Bihyungbetter/Mechanical-Keyboard/cad/Part Studio 1 - Part 1.step

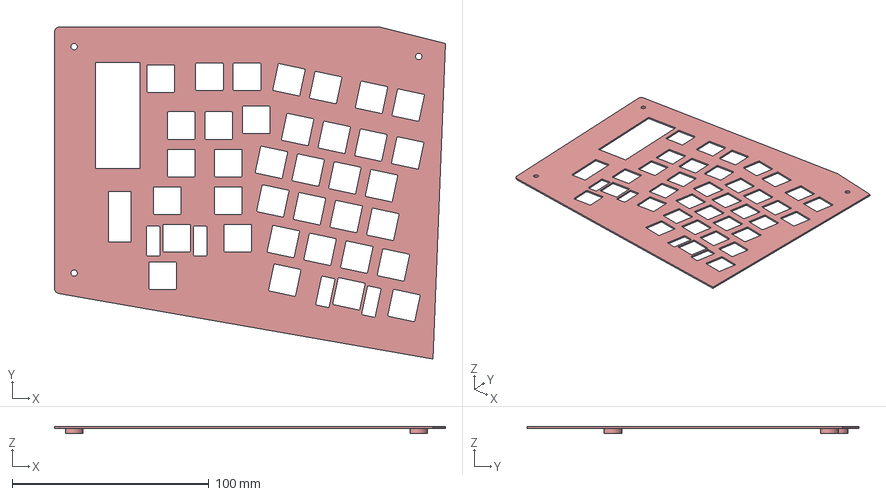
[picture p1: CAD file, 2026-08-08]
cad/Part Studio 1 - Part 1.step
198.6 x 168.6 x 3.58 mm
