Bihyungbetter/Mechanical-Keyboard/cad/Part Studio 1 - Part 2.step

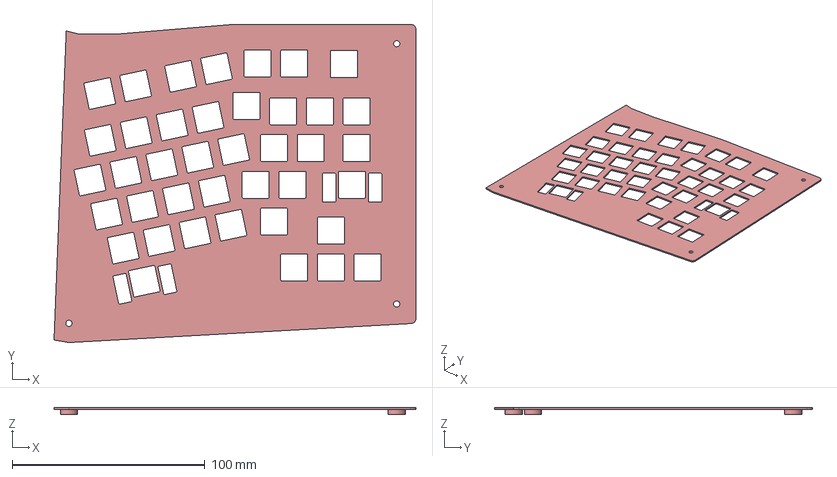
[picture p2: CAD file, 2026-08-08]
cad/Part Studio 1 - Part 2.step
187.7 x 165.0 x 3.58 mm
