Bihyungbetter/Mechanical-Keyboard/cad/Part Studio 1 - Part 5.step

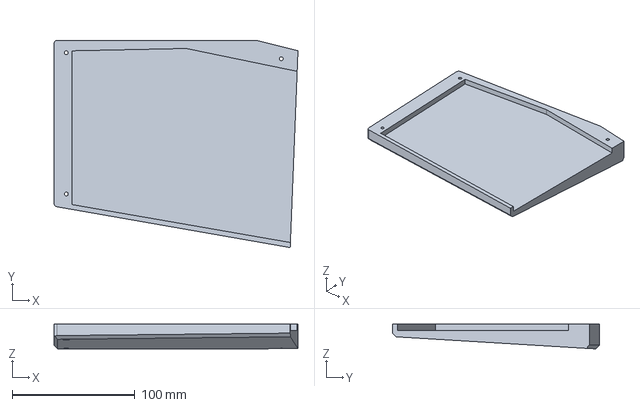
[picture p3: CAD file, 2026-08-08]
cad/Part Studio 1 - Part 5.step
198.6 x 168.6 x 20.0 mm
