Bihyungbetter/Mechanical-Keyboard/cad/Part Studio 1 - Part 4.step

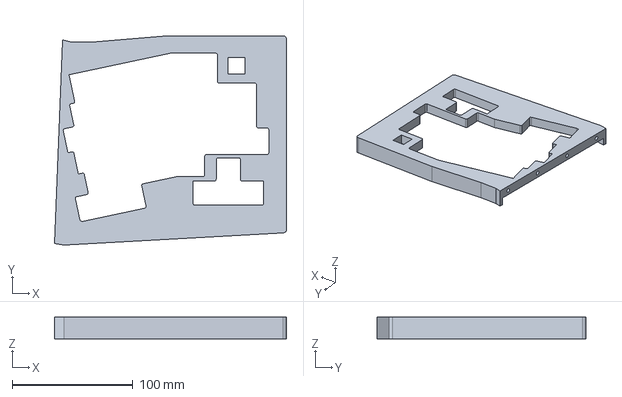
[picture p4: CAD file, 2026-08-08]
cad/Part Studio 1 - Part 4.step
191.9 x 173.0 x 18.0 mm
