Bihyungbetter/Mechanical-Keyboard/cad/Part Studio 1 - Part 3.step

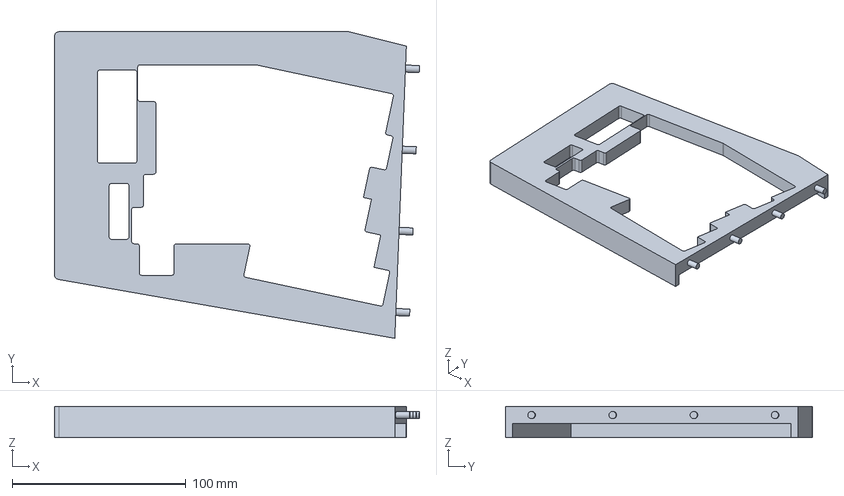
[picture p5: CAD file, 2026-08-08]
cad/Part Studio 1 - Part 3.step
210.3 x 176.7 x 18.0 mm
