Bihyungbetter/Mechanical-Keyboard/cad/Part Studio 1 - Part 6.step

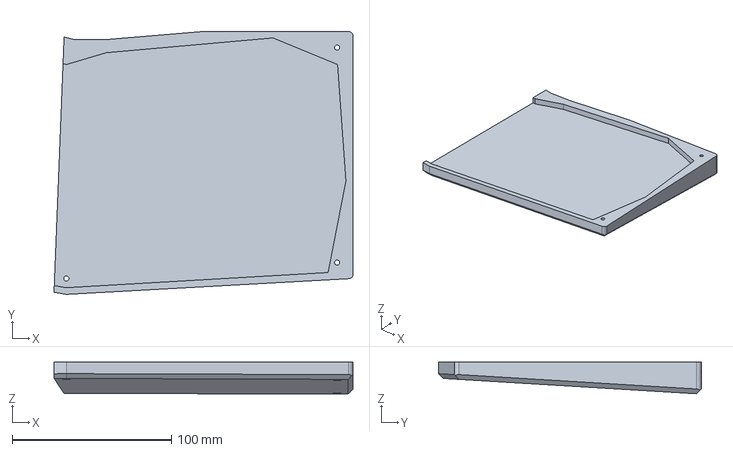
[picture p6: CAD file, 2026-08-08]
cad/Part Studio 1 - Part 6.step
187.7 x 165.0 x 19.8 mm
