Bihyungbetter/Mechanical-Keyboard/(list of files, cad)

Other CAD files:
cad/Master Assembly Keyboard.step
