Bihyungbetter/Mechanical-Keyboard/pcb/Eastern Style Keyboard.kicad_pcb

## KiCad design pcb/Eastern Style Keyboard.kicad_pcb (2026-08-08)

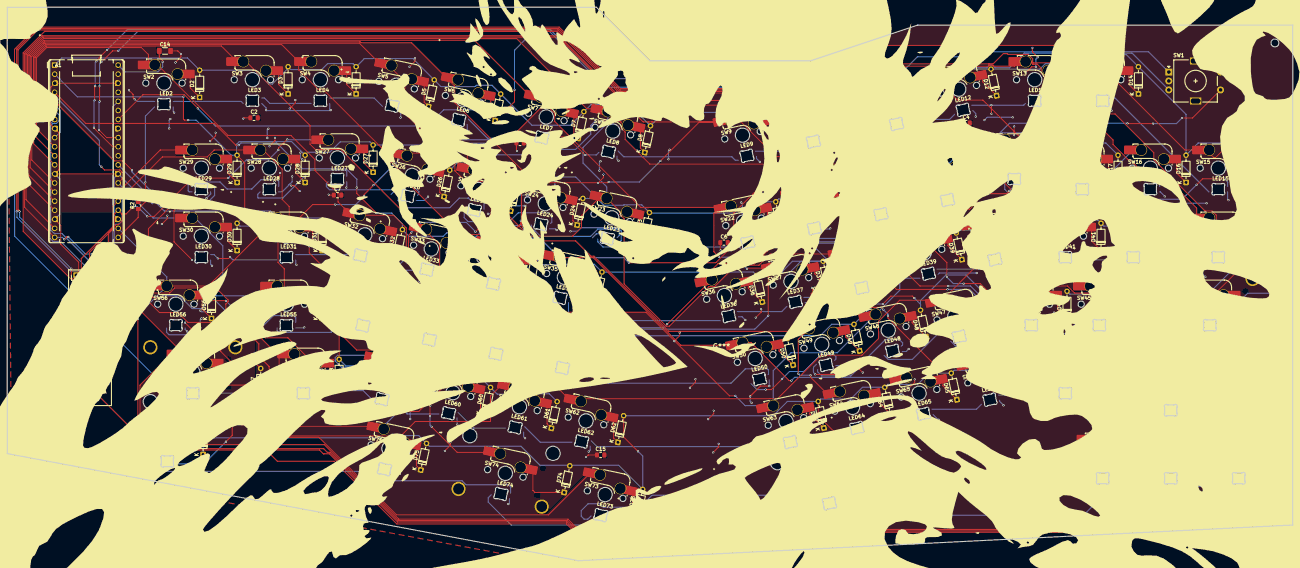
[picture p7: board Eastern Style Keyboard.kicad_pcb from above]

Board: 2 copper layers, 360.0 x 155.0 mm, 255 parts (0 on the bottom side), 178 nets.

Parts:
A1: RaspberryPi_Pico; RaspberryPi_Pico_Common_THT
C2, C3, C4, C5, C6, C7, C8, C9, C10, C11, C12, C13, C15, C16, C17: 100nF; C_0805_2012Metric_Pad1.18x1.45mm_HandSolder
C14: 100µF 10V; C_1206_3216Metric_Pad1.33x1.80mm_HandSolder
D2, D3, D4, D5, D6, D7, D8, D9, D10, D11, D12, D13, D14, D15, D16, D17, D18, D19, D20, D21, D22, D23, D24, D25, D26, D27, D28, D29, D30, D31, D32, D33, D34, D35, D36, D37, D38, D39, D40, D41, D42, D43, D44, D45, D46, D47, D48, D49, D50, D51, D52, D53, D54, D55, D56, D57, D58, D59, D60, D61, D62, D63, D64, D65, D66, D67, D68, D69, D70, D71, D72, D73, D74, D75, D76: 1N4148; D_DO-35_SOD27_P7.62mm_Horizontal
H1, H2, H3, H4, H5, H6: MountingHole; MountingHole_2.2mm_M2
LED2, LED3, LED4, LED5, LED6, LED7, LED8, LED9, LED10, LED11, LED12, LED13, LED14, LED15, LED16, LED17, LED18, LED19, LED20, LED21, LED22, LED23, LED24, LED25, LED26, LED27, LED28, LED29, LED30, LED31, LED32, LED33, LED34, LED35, LED36, LED37, LED38, LED39, LED40, LED41, LED42, LED43, LED44, LED45, LED46, LED47, LED48, LED49, LED50, LED51, LED52, LED53, LED54, LED55, LED56, LED57, LED58, LED59, LED60, LED61, LED62, LED63, LED64, LED65, LED66, LED67, LED68, LED69, LED70, LED71, LED72, LED73, LED74, LED75, LED76: SK6812MINI-E; SK6812MINI-E_fixed
R2: 330 Ω; R_0805_2012Metric_Pad1.20x1.40mm_HandSolder
S1: MX_stab; STAB_MX_P_2u
S2: MX_stab; STAB_MX_P_2.75u
S3, S4: MX_stab; STAB_MX_P_2.25u
SW1: RotaryEncoder_Switch; RotaryEncoder_Alps_EC11E-Switch_Vertical_H20mm
SW2, SW3, SW4, SW5, SW6, SW7, SW8, SW9, SW10, SW11, SW12, SW13, SW14, SW15, SW16, SW17, SW18, SW19, SW20, SW21, SW22, SW23, SW24, SW25, SW26, SW27, SW28, SW29, SW30, SW31, SW32, SW33, SW34, SW35, SW36, SW37, SW38, SW39, SW40, SW41, SW42, SW43, SW44, SW45, SW46, SW47, SW48, SW49, SW50, SW51, SW52, SW53, SW54, SW55, SW56, SW57, SW58, SW59, SW60, SW61, SW62, SW63, SW64, SW65, SW66, SW67, SW68, SW69, SW70, SW71, SW72, SW73, SW74, SW75, SW76: SW_Push; SW_MX_HS_CPG151101S11_1u
U1: ER_OLEDM0.91_1x-I2C

Connections:
+3.3V: A1.36 (3V3), U1.2 (VCC)
Column 0: A1.10 (GPIO7), SW2.2, SW17.2, SW32.2, SW47.2, SW62.2
Column 1: A1.11 (GPIO8), SW3.2, SW18.2, SW33.2, SW48.2, SW63.2
Column 2: A1.12 (GPIO9), SW4.2, SW19.2, SW34.2, SW49.2, SW64.2
Column 3: A1.14 (GPIO10), SW5.2, SW20.2, SW35.2, SW50.2, SW65.2
Column 4: A1.15 (GPIO11), SW6.2, SW21.2, SW36.2, SW51.2, SW66.2
Column 5: A1.16 (GPIO12), SW7.2, SW22.2, SW37.2, SW52.2, SW67.2
Column 6: A1.17 (GPIO13), SW8.2, SW23.2, SW38.2, SW53.2, SW68.2
Column 7: A1.19 (GPIO14), SW9.2, SW24.2, SW39.2, SW54.2, SW69.2
Column 8: A1.20 (GPIO15), SW10.2, SW25.2, SW40.2, SW55.2, SW70.2
Column 9: A1.22 (GPIO17), SW11.2, SW26.2, SW41.2, SW56.2, SW71.2
Column 10: A1.24 (GPIO18), SW12.2, SW27.2, SW42.2, SW57.2, SW72.2
Column 11: A1.25 (GPIO19), SW13.2, SW28.2, SW43.2, SW58.2, SW73.2
Column 12: A1.26 (GPIO20), SW14.2, SW29.2, SW44.2, SW59.2, SW74.2
Column 13: A1.27 (GPIO21), SW15.2, SW30.2, SW45.2, SW60.2, SW75.2
Column 14: A1.29 (GPIO22), SW16.2, SW31.2, SW46.2, SW61.2, SW76.2
GND: A1.3 (GND), A1.8 (GND), A1.13 (GND), A1.18 (GND), A1.23 (GND), A1.28 (GND), A1.38 (GND), C2.1, C3.1, C4.1, C5.1, C6.1, C7.1, C8.1, C9.1, C10.1, C11.1, C12.1, C13.1, C14.2, C15.1, C16.1, C17.1, LED2.1 (VSS), LED3.1 (VSS), LED4.1 (VSS), LED5.1 (VSS), LED6.1 (VSS), LED7.1 (VSS), LED8.1 (VSS), LED9.1 (VSS), LED10.1 (VSS), LED11.1 (VSS), LED12.1 (VSS), LED13.1 (VSS), LED14.1 (VSS), LED15.1 (VSS), LED16.1 (VSS), LED17.1 (VSS), LED18.1 (VSS), LED19.1 (VSS), LED20.1 (VSS), LED21.1 (VSS), LED22.1 (VSS), LED23.1 (VSS), LED24.1 (VSS), LED25.1 (VSS), LED26.1 (VSS), LED27.1 (VSS), LED28.1 (VSS), LED29.1 (VSS), LED30.1 (VSS), LED31.1 (VSS), LED32.1 (VSS), LED33.1 (VSS), LED34.1 (VSS), LED35.1 (VSS), LED36.1 (VSS), LED37.1 (VSS), LED38.1 (VSS), LED39.1 (VSS), LED40.1 (VSS), LED41.1 (VSS), LED42.1 (VSS), LED43.1 (VSS), LED44.1 (VSS), LED45.1 (VSS), LED46.1 (VSS), LED47.1 (VSS), LED48.1 (VSS), LED49.1 (VSS), LED50.1 (VSS), LED51.1 (VSS), LED52.1 (VSS), LED53.1 (VSS), LED54.1 (VSS), LED55.1 (VSS), LED56.1 (VSS), LED57.1 (VSS), LED58.1 (VSS), LED59.1 (VSS), LED60.1 (VSS), LED61.1 (VSS), LED62.1 (VSS), LED63.1 (VSS), LED64.1 (VSS), LED65.1 (VSS), LED66.1 (VSS), LED67.1 (VSS), LED68.1 (VSS), LED69.1 (VSS), LED70.1 (VSS), LED71.1 (VSS), LED72.1 (VSS), LED73.1 (VSS), LED74.1 (VSS), LED75.1 (VSS), LED76.1 (VSS), R2.2, SW1.C, SW1.S2, U1.1 (GND)
KnobA: A1.31 (GPIO26_ADC0), SW1.A
KnobB: A1.32 (GPIO27_ADC1), SW1.B
LED Power: A1.40 (VBUS), C2.2, C3.2, C4.2, C5.2, C6.2, C7.2, C8.2, C9.2, C10.2, C11.2, C12.2, C13.2, C14.1, C15.2, C16.2, C17.2, LED2.3 (VDD), LED3.3 (VDD), LED4.3 (VDD), LED5.3 (VDD), LED6.3 (VDD), LED7.3 (VDD), LED8.3 (VDD), LED9.3 (VDD), LED10.3 (VDD), LED11.3 (VDD), LED12.3 (VDD), LED13.3 (VDD), LED14.3 (VDD), LED15.3 (VDD), LED16.3 (VDD), LED17.3 (VDD), LED18.3 (VDD), LED19.3 (VDD), LED20.3 (VDD), LED21.3 (VDD), LED22.3 (VDD), LED23.3 (VDD), LED24.3 (VDD), LED25.3 (VDD), LED26.3 (VDD), LED27.3 (VDD), LED28.3 (VDD), LED29.3 (VDD), LED30.3 (VDD), LED31.3 (VDD), LED32.3 (VDD), LED33.3 (VDD), LED34.3 (VDD), LED35.3 (VDD), LED36.3 (VDD), LED37.3 (VDD), LED38.3 (VDD), LED39.3 (VDD), LED40.3 (VDD), LED41.3 (VDD), LED42.3 (VDD), LED43.3 (VDD), LED44.3 (VDD), LED45.3 (VDD), LED46.3 (VDD), LED47.3 (VDD), LED48.3 (VDD), LED49.3 (VDD), LED50.3 (VDD), LED51.3 (VDD), LED52.3 (VDD), LED53.3 (VDD), LED54.3 (VDD), LED55.3 (VDD), LED56.3 (VDD), LED57.3 (VDD), LED58.3 (VDD), LED59.3 (VDD), LED60.3 (VDD), LED61.3 (VDD), LED62.3 (VDD), LED63.3 (VDD), LED64.3 (VDD), LED65.3 (VDD), LED66.3 (VDD), LED67.3 (VDD), LED68.3 (VDD), LED69.3 (VDD), LED70.3 (VDD), LED71.3 (VDD), LED72.3 (VDD), LED73.3 (VDD), LED74.3 (VDD), LED75.3 (VDD), LED76.3 (VDD)
Led S: A1.21 (GPIO16), LED2.2 (DIN), R2.1
unnamed: A1.6 (GPIO4), U1.4 (SDA)
unnamed: A1.7 (GPIO5), U1.3 (SCL)
unnamed: D2.1 (K), SW2.1
unnamed: D3.1 (K), SW3.1
unnamed: D4.1 (K), SW4.1
unnamed: D5.1 (K), SW5.1
unnamed: D6.1 (K), SW6.1
unnamed: D7.1 (K), SW7.1
unnamed: D8.1 (K), SW8.1
unnamed: D9.1 (K), SW9.1
unnamed: D10.1 (K), SW10.1
unnamed: D11.1 (K), SW11.1
unnamed: D12.1 (K), SW12.1
unnamed: D13.1 (K), SW13.1
unnamed: D14.1 (K), SW14.1
unnamed: D15.1 (K), SW15.1
unnamed: D16.1 (K), SW16.1
unnamed: D17.1 (K), SW17.1
unnamed: D18.1 (K), SW18.1
unnamed: D19.1 (K), SW19.1
unnamed: D20.1 (K), SW20.1
unnamed: D21.1 (K), SW21.1
unnamed: D22.1 (K), SW22.1
unnamed: D23.1 (K), SW23.1
unnamed: D24.1 (K), SW24.1
unnamed: D25.1 (K), SW25.1
unnamed: D26.1 (K), SW26.1
unnamed: D27.1 (K), SW27.1
unnamed: D28.1 (K), SW28.1
unnamed: D29.1 (K), SW29.1
unnamed: D30.1 (K), SW30.1
unnamed: D31.1 (K), SW31.1
unnamed: D32.1 (K), SW32.1
unnamed: D33.1 (K), SW33.1
unnamed: D34.1 (K), SW34.1
unnamed: D35.1 (K), SW35.1
unnamed: D36.1 (K), SW36.1
unnamed: D37.1 (K), SW37.1
unnamed: D38.1 (K), SW38.1
unnamed: D39.1 (K), SW39.1
unnamed: D40.1 (K), SW40.1
unnamed: D41.1 (K), SW41.1
unnamed: D42.1 (K), SW42.1
unnamed: D43.1 (K), SW43.1
unnamed: D44.1 (K), SW44.1
unnamed: D45.1 (K), SW45.1
unnamed: D46.1 (K), SW46.1
unnamed: D47.1 (K), SW47.1
unnamed: D48.1 (K), SW48.1
unnamed: D49.1 (K), SW49.1
unnamed: D50.1 (K), SW50.1
unnamed: D51.1 (K), SW51.1
unnamed: D52.1 (K), SW52.1
unnamed: D53.1 (K), SW53.1
unnamed: D54.1 (K), SW54.1
unnamed: D55.1 (K), SW55.1
unnamed: D56.1 (K), SW56.1
unnamed: D57.1 (K), SW57.1
unnamed: D58.1 (K), SW58.1
unnamed: D59.1 (K), SW59.1
unnamed: D60.1 (K), SW60.1
unnamed: D61.1 (K), SW61.1
unnamed: D62.1 (K), SW62.1
unnamed: D63.1 (K), SW63.1
unnamed: D64.1 (K), SW64.1
unnamed: D65.1 (K), SW65.1
unnamed: D66.1 (K), SW66.1
unnamed: D67.1 (K), SW67.1
unnamed: D68.1 (K), SW68.1
unnamed: D69.1 (K), SW69.1
unnamed: D70.1 (K), SW70.1
unnamed: D71.1 (K), SW71.1
unnamed: D72.1 (K), SW72.1
unnamed: D73.1 (K), SW73.1
unnamed: D74.1 (K), SW74.1
unnamed: D75.1 (K), SW75.1
unnamed: D76.1 (K), SW76.1
unnamed: LED2.4 (DOUT), LED3.2 (DIN)
unnamed: LED3.4 (DOUT), LED4.2 (DIN)
unnamed: LED4.4 (DOUT), LED5.2 (DIN)
unnamed: LED5.4 (DOUT), LED6.2 (DIN)
unnamed: LED6.4 (DOUT), LED7.2 (DIN)
unnamed: LED7.4 (DOUT), LED8.2 (DIN)
unnamed: LED8.4 (DOUT), LED9.2 (DIN)
unnamed: LED9.4 (DOUT), LED10.2 (DIN)
unnamed: LED10.4 (DOUT), LED11.2 (DIN)
unnamed: LED11.4 (DOUT), LED12.2 (DIN)
unnamed: LED12.4 (DOUT), LED13.2 (DIN)
unnamed: LED13.4 (DOUT), LED14.2 (DIN)
unnamed: LED14.4 (DOUT), LED15.2 (DIN)
unnamed: LED15.4 (DOUT), LED16.2 (DIN)
unnamed: LED16.4 (DOUT), LED17.2 (DIN)
unnamed: LED17.4 (DOUT), LED18.2 (DIN)
unnamed: LED18.4 (DOUT), LED19.2 (DIN)
unnamed: LED19.4 (DOUT), LED20.2 (DIN)
unnamed: LED20.4 (DOUT), LED21.2 (DIN)
unnamed: LED21.4 (DOUT), LED22.2 (DIN)
unnamed: LED22.4 (DOUT), LED23.2 (DIN)
unnamed: LED23.4 (DOUT), LED24.2 (DIN)
unnamed: LED24.4 (DOUT), LED25.2 (DIN)
unnamed: LED25.4 (DOUT), LED26.2 (DIN)
unnamed: LED26.4 (DOUT), LED27.2 (DIN)
unnamed: LED27.4 (DOUT), LED28.2 (DIN)
unnamed: LED28.4 (DOUT), LED29.2 (DIN)
unnamed: LED29.4 (DOUT), LED30.2 (DIN)
unnamed: LED30.4 (DOUT), LED31.2 (DIN)
unnamed: LED31.4 (DOUT), LED32.2 (DIN)
unnamed: LED32.4 (DOUT), LED33.2 (DIN)
unnamed: LED33.4 (DOUT), LED34.2 (DIN)
unnamed: LED34.4 (DOUT), LED35.2 (DIN)
unnamed: LED35.4 (DOUT), LED36.2 (DIN)
unnamed: LED36.4 (DOUT), LED37.2 (DIN)
unnamed: LED37.4 (DOUT), LED38.2 (DIN)
unnamed: LED38.4 (DOUT), LED39.2 (DIN)
unnamed: LED39.4 (DOUT), LED40.2 (DIN)
unnamed: LED40.4 (DOUT), LED41.2 (DIN)
unnamed: LED41.4 (DOUT), LED42.2 (DIN)
unnamed: LED42.4 (DOUT), LED43.2 (DIN)
unnamed: LED43.4 (DOUT), LED44.2 (DIN)
unnamed: LED44.4 (DOUT), LED45.2 (DIN)
unnamed: LED45.4 (DOUT), LED46.2 (DIN)
unnamed: LED46.4 (DOUT), LED47.2 (DIN)
unnamed: LED47.4 (DOUT), LED48.2 (DIN)
unnamed: LED48.4 (DOUT), LED49.2 (DIN)
unnamed: LED49.4 (DOUT), LED50.2 (DIN)
unnamed: LED50.4 (DOUT), LED51.2 (DIN)
unnamed: LED51.4 (DOUT), LED52.2 (DIN)
unnamed: LED52.4 (DOUT), LED53.2 (DIN)
unnamed: LED53.4 (DOUT), LED54.2 (DIN)
unnamed: LED54.4 (DOUT), LED55.2 (DIN)
unnamed: LED55.4 (DOUT), LED56.2 (DIN)
unnamed: LED56.4 (DOUT), LED57.2 (DIN)
unnamed: LED57.4 (DOUT), LED58.2 (DIN)
unnamed: LED58.4 (DOUT), LED59.2 (DIN)
unnamed: LED59.4 (DOUT), LED60.2 (DIN)
unnamed: LED60.4 (DOUT), LED61.2 (DIN)
unnamed: LED61.4 (DOUT), LED62.2 (DIN)
unnamed: LED62.4 (DOUT), LED63.2 (DIN)
unnamed: LED63.4 (DOUT), LED64.2 (DIN)
unnamed: LED64.4 (DOUT), LED65.2 (DIN)
unnamed: LED65.4 (DOUT), LED66.2 (DIN)
unnamed: LED66.4 (DOUT), LED67.2 (DIN)
unnamed: LED67.4 (DOUT), LED68.2 (DIN)
unnamed: LED68.4 (DOUT), LED69.2 (DIN)
unnamed: LED69.4 (DOUT), LED70.2 (DIN)
unnamed: LED70.4 (DOUT), LED71.2 (DIN)
unnamed: LED71.4 (DOUT), LED72.2 (DIN)
unnamed: LED72.4 (DOUT), LED73.2 (DIN)
unnamed: LED73.4 (DOUT), LED74.2 (DIN)
unnamed: LED74.4 (DOUT), LED75.2 (DIN)
unnamed: LED75.4 (DOUT), LED76.2 (DIN)
Push: A1.34 (GPIO28_ADC2), SW1.S1
Row 0: A1.1 (GPIO0), D2.2 (A), D3.2 (A), D4.2 (A), D5.2 (A), D6.2 (A), D7.2 (A), D8.2 (A), D9.2 (A), D10.2 (A), D11.2 (A), D12.2 (A), D13.2 (A), D14.2 (A), D15.2 (A), D16.2 (A)
Row 1: A1.2 (GPIO1), D17.2 (A), D18.2 (A), D19.2 (A), D20.2 (A), D21.2 (A), D22.2 (A), D23.2 (A), D24.2 (A), D25.2 (A), D26.2 (A), D27.2 (A), D28.2 (A), D29.2 (A), D30.2 (A), D31.2 (A)
Row 2: A1.4 (GPIO2), D32.2 (A), D33.2 (A), D34.2 (A), D35.2 (A), D36.2 (A), D37.2 (A), D38.2 (A), D39.2 (A), D40.2 (A), D41.2 (A), D42.2 (A), D43.2 (A), D44.2 (A), D45.2 (A), D46.2 (A)
Row 3: A1.5 (GPIO3), D47.2 (A), D48.2 (A), D49.2 (A), D50.2 (A), D51.2 (A), D52.2 (A), D53.2 (A), D54.2 (A), D55.2 (A), D56.2 (A), D57.2 (A), D58.2 (A), D59.2 (A), D60.2 (A), D61.2 (A)
Row 4: A1.9 (GPIO6), D62.2 (A), D63.2 (A), D64.2 (A), D65.2 (A), D66.2 (A), D67.2 (A), D68.2 (A), D69.2 (A), D70.2 (A), D71.2 (A), D72.2 (A), D73.2 (A), D74.2 (A), D75.2 (A), D76.2 (A)
