Bihyungbetter/Mechanical-Keyboard/JOURNAL.md

## Journal
Total of 14 hours worked, with some hours I forgot to record. 

# Schematics
https://lapse.hackclub.com/timelapse/dylp4JkiU-bz


Spent 1 and a half hours finishing the Schematic. Was pretty easy given I have already made a hackpad. 

# PCB
https://lapse.hackclub.com/timelapse/lejlmrSzfBrg


Oh, this was bad. I spent hours tracing; the LEDs made it really hard. Also I spent like 3 hours figuring out how to stitch together the pours. But at least I learned!. 

# CAD 
https://lapse.hackclub.com/timelapse/hK0Iuz8Fk1QQ


Started on the CAD but realized my LEDs were in the front, so I guess I hate to retrace now! 

# Finishing Up
https://lapse.hackclub.com/timelapse/D8OVPo_X53pJ


Went through the painful process of tracing again, cleaned up and finished the CAD, and did the firmware.
