Bihyungbetter/Mechanical-Keyboard/(commit log)

2026-08-08 Initial Eastern Style Keyboard project
    [Eastern Style Keyboard.kicad_pcb, Eastern Style Keyboard.kicad_sch, Part Studio 1 - Part 1.step, Part Studio 1 - Part 2.step, Part Studio 1 - Part 3.step, Part Studio 1 - Part 4.step, Part Studio 1 - Part 5.step, Part Studio 1 - Part 6.step]
2026-08-08 Add assembly purchase items to BOM
    [bom.csv]
2026-08-09 Add keycaps and update screw quantity
    [bom.csv]
2026-08-09 Add readable BOM copy
    [bom_readable.csv]
2026-08-09 Make readable BOM the primary file
    [bom.csv, bom_for_order.csv, bom_readable.csv]
2026-08-09 Add pictures to README for assembly guidance
    Added images to the README for assembly reference.
2026-08-09 Update journal with work hours and task details
    Added total hours worked and detailed progress on various tasks including schematics, PCB, and CAD.
2026-10-20 Add BOM.csv
    [BOM.csv]
2026-10-20 Add BOM section to README
2026-10-20 Switch keycaps to Daylight PBT set
    [BOM.csv]
2026-10-20 Update README BOM with new keycaps
2026-10-22 Add Onshape link to README
    Added Onshape link for CAD documentation.
2026-10-22 Revise journal with CAD updates and finishing details
    Updated journal entries with new CAD and finishing up sections, including images and links.
2026-10-26 Revise CAD description and remove BOM section
    Updated the CAD section and removed the BOM details from the README.
2026-10-26 Add master assembly STEP via Git LFS
    [Master Assembly.step]
2026-11-11 Replace master assembly STEP with updated keyboard assembly
    [Master Assembly Keyboard.step, Master Assembly.step]
2026-11-11 Clean up repo: remove duplicate gerber zip and unused assembly files
    [bom.csv, bom_for_order.csv, designators.csv, positions.csv]
